tbec/AirUv2.0/airu_board_dimensions.JPG

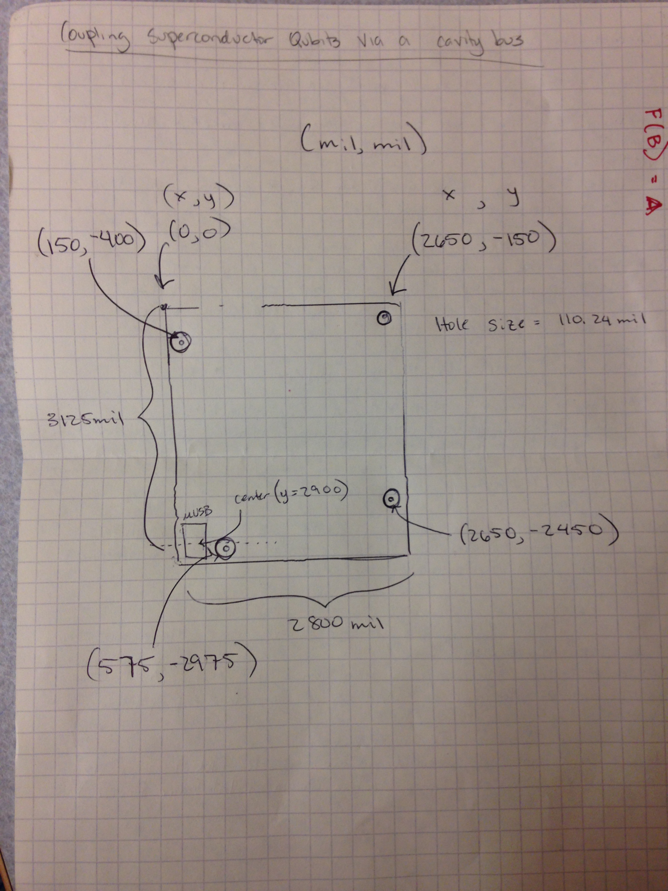
airu_board_dimensions.JPG
