tbec/AirUv2.0/airu_v2.0_board_wADC/README.md

# AirUv2.0 Schematic and Layout

Last Modified: September 7, 2018 by Trenton Taylor
