tbec/AirUv2.0/airu_v2.0_board_wPOE/README.md

# AirUv2.0 Schematic and Layout

Last Modified: …
