tbec/AirUv2.0/AIRUV2_BOM_SEEED_ALL_PARTS.xlsx

Designator | MPN/Seeed SKU | Qty | Ref
C18,C19 | 302010143 | 2 | 22PF 0603
C15,C5,C9 | 302010076 | 3 | 100PF 0603
C12 | 302010088 | 1 | 33NF 0603
C20,C16,C27,C23,C26 | 302010138 | 5 | 100NF 0603
C21 | 302010171 | 1 | 22UF 0805
C17,C3,C4,C13,C22,C2,C28 | 302010139 | 7 | 1UF 0603
C1,C6,C7,C25,C14,C24 | 302010103 | 6 | 10UF 0603
R24 | RC0603JR-0751RL (https://www.digikey.com/product-detail/en/yageo/RC0603JR-0751RL/311-51GRTR-ND/726803) | 1 | 51R 0603
R23,R21 | RC0603JR-0782RL (https://www.digikey.com/product-detail/en/yageo/RC0603JR-0782RL/311-82GRTR-ND/726834) | 2 | 82R 0603
R12 | 301010292 | 1 | 0R 0603
R16 | 301010096 | 1 | 10R 0603
R5,R6,R2 | 301010090 | 3 | 100R 0603
R35,R33,R14,R34,R38,R37,R7 | 301010163 | 7 | 220R 0603
R11,R20 | 301010291 | 2 | 1k 0603
R22,R10 | 301010290 | 2 | 4.7K 0603
R1,R3,R4,R13,R9,R15,R17,R8 | 301010299 | 8 | 10K 0603
L3 | 303030006 | 1 | FERITE BEAD
L2 | 303010682 | 1 | 6.8NH 0402
D4 | 304090044 | 1 | LED-Y 0603
D1 | 304090042 | 1 | LED-R 0603
D2 | 304090043 | 1 | LED-G 0603
D3 | 304090045 | 1 | LED-B 0603
Y1 | 306010047 | 1 | CRYSTAL
U9 | MICS-4514 | 1 | MICS4514
U1 | HDC1080DMBT | 1 | HDC1080
U8 | TLV2333IDGKR | 1 | TLV2333
U6 | 53261-0871 | 1 | MOLEX CONNECTOR
U5 | 317050012 | 1 | L70-M39
U3 | 310030097 | 1 | CJT1117
U2 | 310070026 | 1 | CH340T
U4 | 310060024 | 1 | MAX2659
U7 | ESP32-WROOM-32 | 1 | CPU
ANT1 | 318010020 | 1 | ACD5036-A3
Q2,Q3 | 305010013 | 2 | MMBT3904 TRANSISTOR
Q1 | 305030000 | 1 | BSS138W TRANSISTOR
Q5 | 305030010 | 1 | NCE3407A TRANSISTOR
J2,J1 | 320020017 | 2 | 4PIN,6PIN MALE HEADERS
USB1 | 320010005 | 1 | microUSB CONNECTOR
SD1 | 320090000 | 1 | SD CONNECTOR
BT1 | 320170002 | 1 | BATTERY CONNECTOR CR1220
S1,S2 | 311020024 | 2 | TS-1109
