tbec/AirUv2.0/(commit log)

2018-10-03 add v2 board eagle files
    [AirU_v2.0.brd, AirU_v2.0.sch]
2018-10-04 add bom file for v2.0 board
    [AIRUV2_BOM_SEEED_ALL_PARTS.xlsx]
2018-10-04 add readme to board diirectory
2018-10-04 add v2.0 board dimensions
2018-10-04 add anternate v2.0 boards
    [AirU_v2.0_wADC.brd, AirU_v2.0_wADC.sch, AirU_v2.0_wPOE.brd, AirU_v2.0_wPOE.sch]
2018-10-04 rename dir for board
    [AirU_v2.0.brd, AirU_v2.0.sch]
2018-10-04 try to rename dir
    [AirU_v2.0.brd, AirU_v2.0.sch]
2018-10-04 add eagle files for v2.0 board
    [AirU_v2.0.brd, AirU_v2.0.sch]
